Janosinth/3-Channel_EMG_PCB/Video and Image Assets/Bare PCB.png

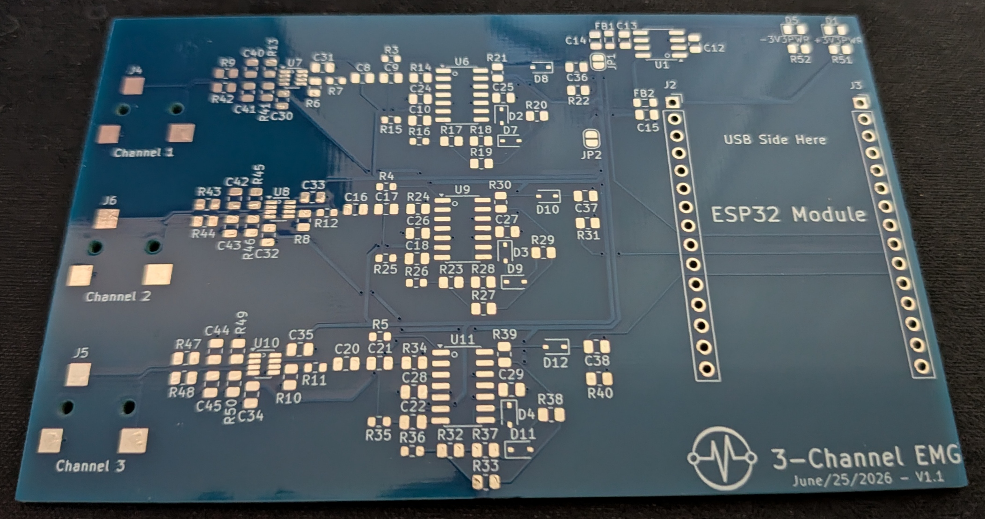
Video and Image Assets/Bare PCB.png
