Janosinth/3-Channel_EMG_PCB/Video and Image Assets/KiCad PCB schematic .png

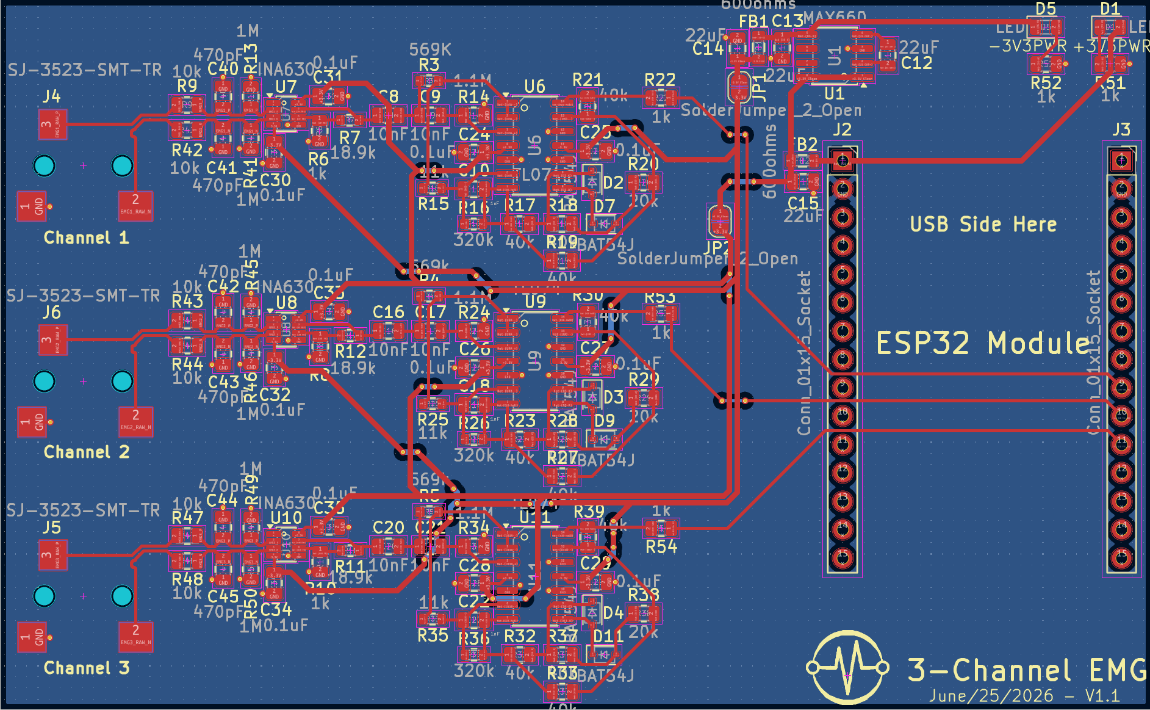
Video and Image Assets/KiCad PCB schematic .png
