Janosinth/3-Channel_EMG_PCB/Hardware/Kicad_Files/SJ-3523-SMT-TR.step

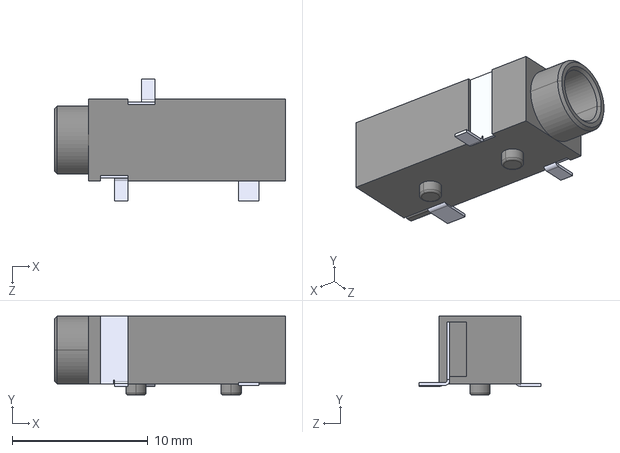
[picture p5: CAD file, 2026-10-20]
Hardware/Kicad_Files/SJ-3523-SMT-TR.step
17.0 x 5.80 x 9.00 mm
