Janosinth/3-Channel_EMG_PCB/(list of files, drawings)

Other design files:
Simulations/EMG_Circuit_Simulation.ms14
