Janosinth/3-Channel_EMG_PCB/Hardware/Kicad_Files/EMG2.kicad_pcb

## KiCad design Hardware/Kicad_Files/EMG2.kicad_pcb (2026-10-20)

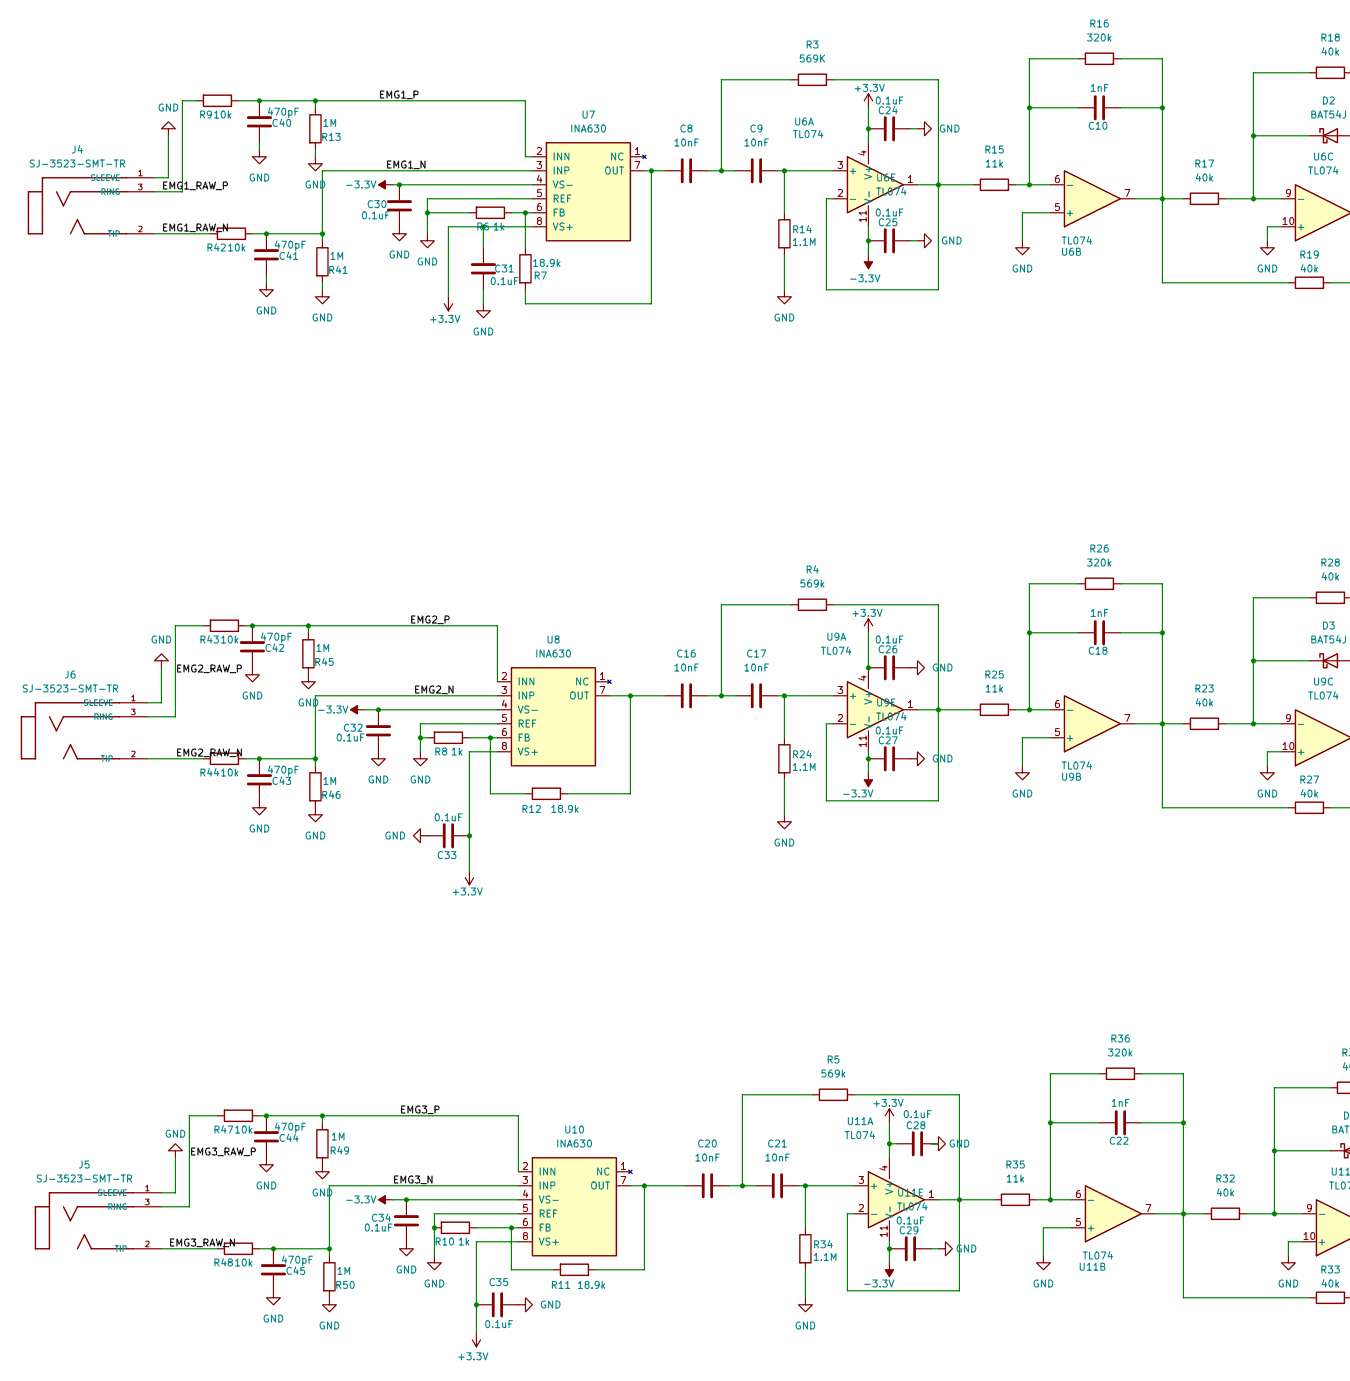
[picture p6: schematic EMG2.kicad_sch, part in row 1, column 1]

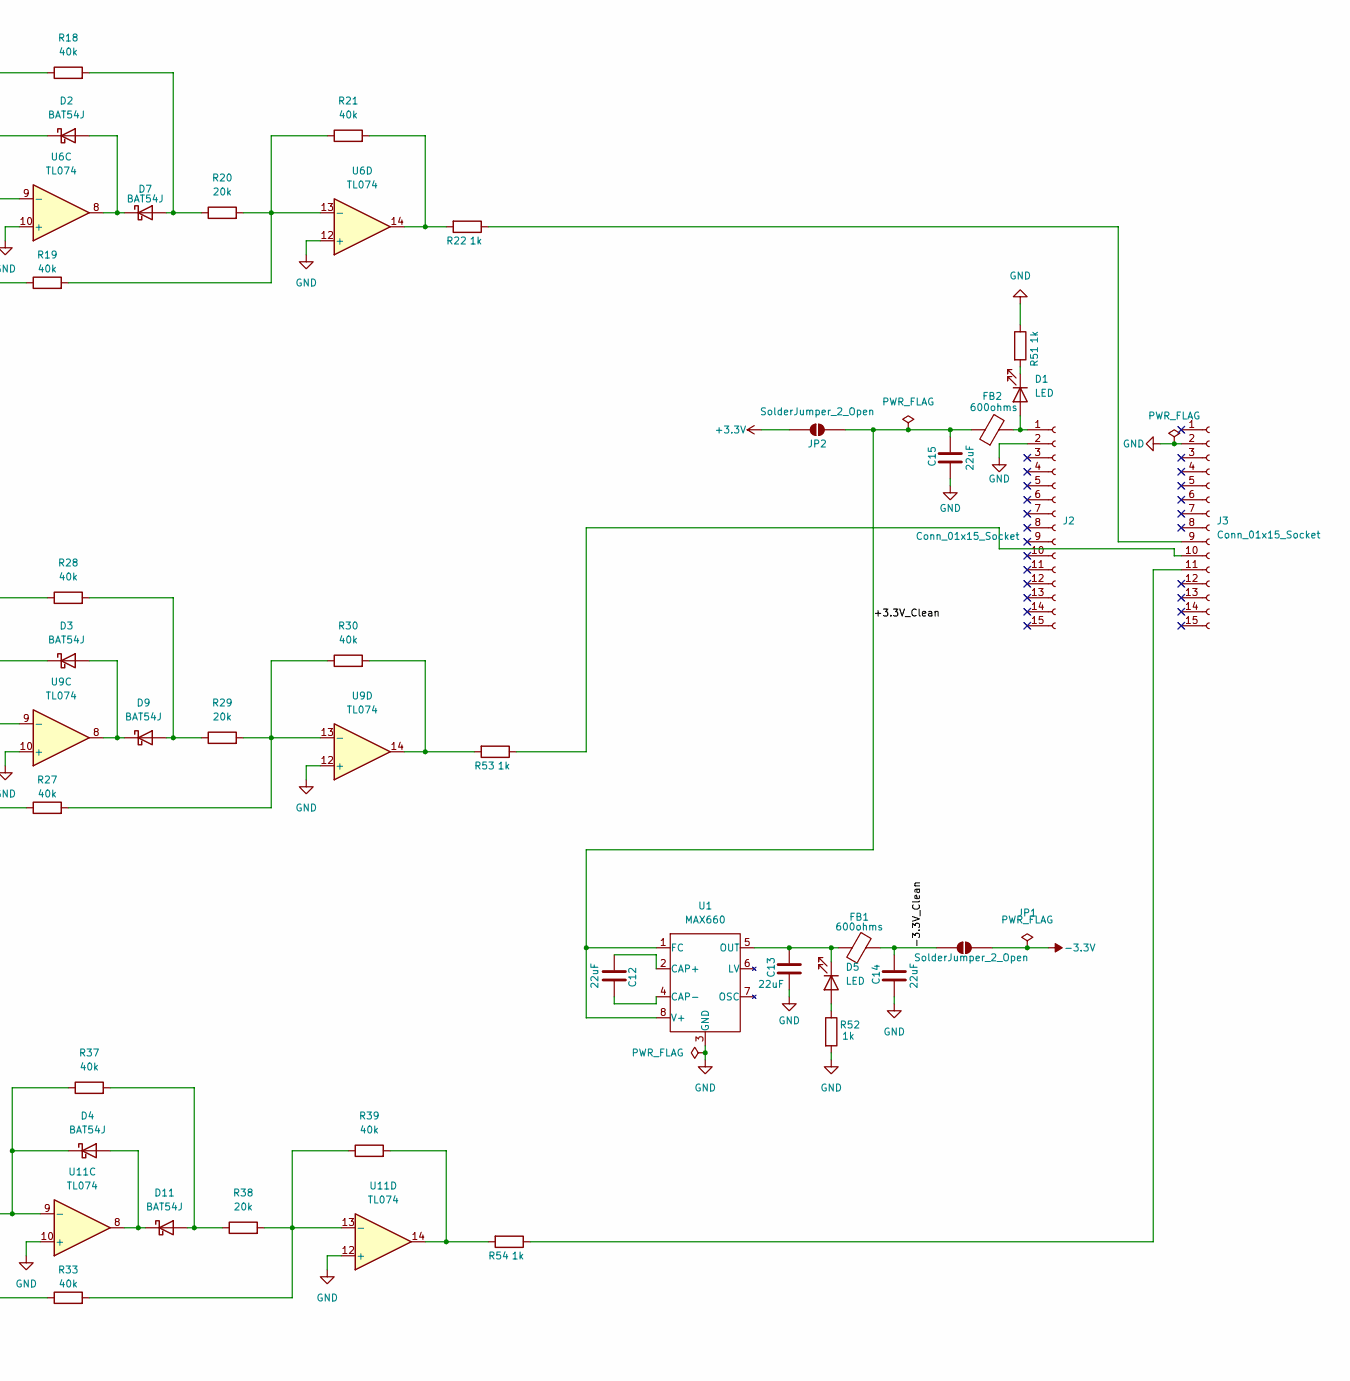
[picture p7: schematic EMG2.kicad_sch, part in row 1, column 2]

Parts:
C8, C9, C16, C17, C20, C21: 10nF; C_0805_2012Metric
C10, C18, C22: 1nF; C_0805_2012Metric
C12, C13, C14, C15: 22uF; C_0805_2012Metric
C24, C25, C26, C27, C28, C29, C30, C31, C32, C33, C34, C35: 0.1uF; C_0805_2012Metric
C40, C41, C42, C43, C44, C45: 470pF; C_0805_2012Metric
D1, D5: LED; LED_0805_2012Metric
D2, D3, D4, D7, D9, D11: BAT54J; D_SOD-323
FB1, FB2: 600ohms; L_0805_2012Metric
J2, J3: Conn_01x15_Socket; PinSocket_1x15_P2.54mm_Vertical
J4, J5, J6: SJ-3523-SMT-TR; CUI_SJ-3523-SMT-TR
JP1, JP2: SolderJumper_2_Open; SolderJumper-2_P1.3mm_Open_RoundedPad1.0x1.5mm
R3: 569K; R_0603_1608Metric
R4, R5: 569k; R_0603_1608Metric
R6, R8, R10, R22, R51, R52, R53, R54: 1k; R_0805_2012Metric
R7, R11, R12: 18.9k; R_0603_1608Metric
R9, R42, R43, R44, R47, R48: 10k; R_0805_2012Metric
R13, R41, R45, R46, R49, R50: 1M; R_0805_2012Metric
R14, R24, R34: 1.1M; R_0805_2012Metric
R15, R25, R35: 11k; R_0603_1608Metric
R16, R26, R36: 320k; R_0603_1608Metric
R17, R18, R19, R21, R23, R27, R28, R30, R32, R33, R37, R39: 40k; R_0805_2012Metric
R20, R29, R38: 20k; R_0805_2012Metric
U1: MAX660; SOIC-8_3.9x4.9mm_P1.27mm
U6, U9, U11: TL074; SOIC-14_3.9x8.7mm_P1.27mm
U7, U8, U10: INA630; TSOT-23-8

Connections:
+3.3V: C24.1, C26.1, C28.1, C31.1, C33.1, C35.1, JP2.2 (B), U6.4 (V+), U7.8 (VS+), U8.8 (VS+), U9.4 (V+), U10.8 (VS+), U11.4 (V+)
-3.3V: C25.1, C27.1, C29.1, C30.1, C32.1, C34.1, JP1.2 (B), U6.11 (V-), U7.4 (VS-), U8.4 (VS-), U9.11 (V-), U10.4 (VS-), U11.11 (V-)
/+3.3V_Clean: C15.1, FB2.1, JP2.1 (A), U1.1 (FC), U1.8 (V+)
/-3.3V_Clean: C14.1, FB1.2, JP1.1 (A)
/EMG1_N: C41.2, R41.1, R42.1, U7.3 (INP)
/EMG1_P: C40.2, R9.1, R13.1, U7.2 (INN)
/EMG1_RAW_N: J4.2 (TIP), R42.2
/EMG1_RAW_P: J4.3 (RING), R9.2
/EMG2_N: C43.2, R44.1, R46.1, U8.3 (INP)
/EMG2_P: C42.2, R43.1, R45.1, U8.2 (INN)
/EMG2_RAW_N: J6.2 (TIP), R44.2
/EMG2_RAW_P: J6.3 (RING), R43.2
/EMG3_N: C45.2, R48.1, R50.1, U10.3 (INP)
/EMG3_P: C44.2, R47.1, R49.1, U10.2 (INN)
/EMG3_RAW_N: J5.2 (TIP), R48.2
/EMG3_RAW_P: J5.3 (RING), R47.2
GND: C13.2, C14.2, C15.2, C24.2, C25.2, C26.2, C27.2, C28.2, C29.2, C30.2, C31.2, C32.2, C33.2, C34.2, C35.2, C40.1, C41.1, C42.1, C43.1, C44.1, C45.1, J2.2, J3.2, J4.1 (SLEEVE), J5.1 (SLEEVE), J6.1 (SLEEVE), R6.2, R8.2, R10.2, R13.2, R14.2, R24.2, R34.2, R41.2, R45.2, R46.2, R49.2, R50.2, R51.1, R52.2, U1.3 (GND), U6.5 (+), U6.10 (+), U6.12 (+), U7.5 (REF), U8.5 (REF), U9.5 (+), U9.10 (+), U9.12 (+), U10.5 (REF), U11.5 (+), U11.10 (+), U11.12 (+)
unnamed: C8.2, C9.1, R3.1
unnamed: C10.2, R16.2, R17.1, R19.1, U6.7
unnamed: C16.2, C17.1, R4.1
unnamed: C18.2, R23.1, R26.2, R27.1, U9.7
unnamed: C20.2, C21.1, R5.1
unnamed: C22.2, R32.1, R33.1, R36.2, U11.7
unnamed: D1.2 (A), FB2.2, J2.1
unnamed: D1.1 (K), R51.2
unnamed: D2.2 (A), D7.1 (K), U6.8
unnamed: D2.1 (K), R17.2, R18.1, U6.9 (-)
unnamed: D3.2 (A), D9.1 (K), U9.8
unnamed: D3.1 (K), R23.2, R28.1, U9.9 (-)
unnamed: D4.1 (K), R32.2, R37.1, U11.9 (-)
unnamed: D5.2 (A), R52.1
unnamed: C13.1, D5.1 (K), FB1.1, U1.5 (OUT)
unnamed: D7.2 (A), R18.2, R20.1
unnamed: D9.2 (A), R28.2, R29.1
unnamed: D11.2 (A), R37.2, R38.1
unnamed: D4.2 (A), D11.1 (K), U11.8
unnamed: J3.9, R22.1
unnamed: J3.10, R53.1
unnamed: J3.11, R54.1
unnamed: R21.2, R22.2, U6.14
unnamed: R30.2, R53.2, U9.14
unnamed: R39.2, R54.2, U11.14
unnamed: C12.2, U1.2 (CAP+)
unnamed: C12.1, U1.4 (CAP-)
unnamed: C9.2, R14.1, U6.3 (+)
unnamed: R3.2, R15.1, U6.1, U6.2 (-)
unnamed: C10.1, R15.2, R16.1, U6.6 (-)
unnamed: R19.2, R20.2, R21.1, U6.13 (-)
unnamed: R6.1, R7.1, U7.6 (FB)
unnamed: C8.1, R7.2, U7.7 (OUT)
unnamed: R8.1, R12.2, U8.6 (FB)
unnamed: C16.1, R12.1, U8.7 (OUT)
unnamed: C17.2, R24.1, U9.3 (+)
unnamed: R4.2, R25.1, U9.1, U9.2 (-)
unnamed: C18.1, R25.2, R26.1, U9.6 (-)
unnamed: R27.2, R29.2, R30.1, U9.13 (-)
unnamed: R10.1, R11.2, U10.6 (FB)
unnamed: C20.1, R11.1, U10.7 (OUT)
unnamed: C21.2, R34.1, U11.3 (+)
unnamed: R5.2, R35.1, U11.1, U11.2 (-)
unnamed: C22.1, R35.2, R36.1, U11.6 (-)
unnamed: R33.2, R38.2, R39.1, U11.13 (-)

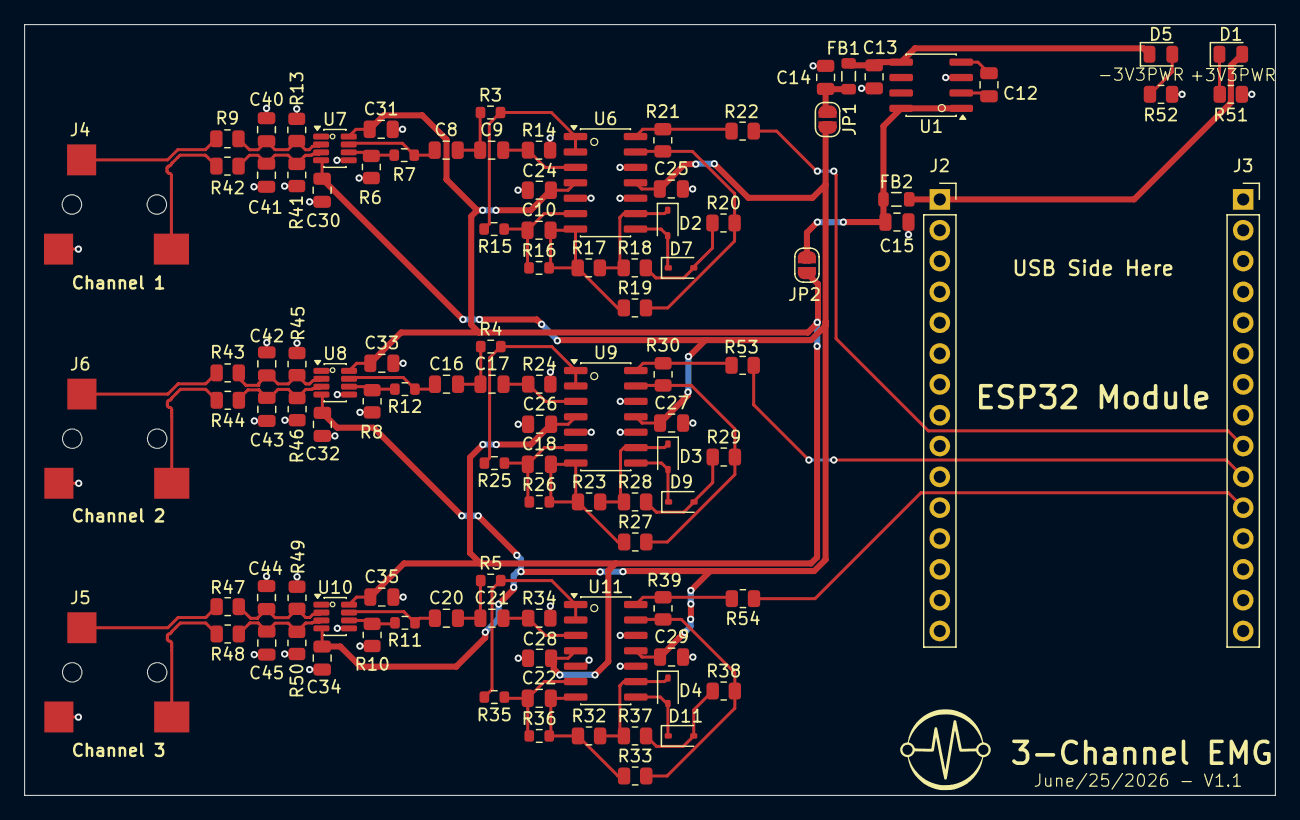
[picture p8: board EMG2.kicad_pcb from above]

Board: 4 copper layers, 103.1 x 63.5 mm, 105 parts (0 on the bottom side), 62 nets.
